RwHexa/ZaehlerModbus/ZaehlerGoogle/ScreenshotZaehler.png

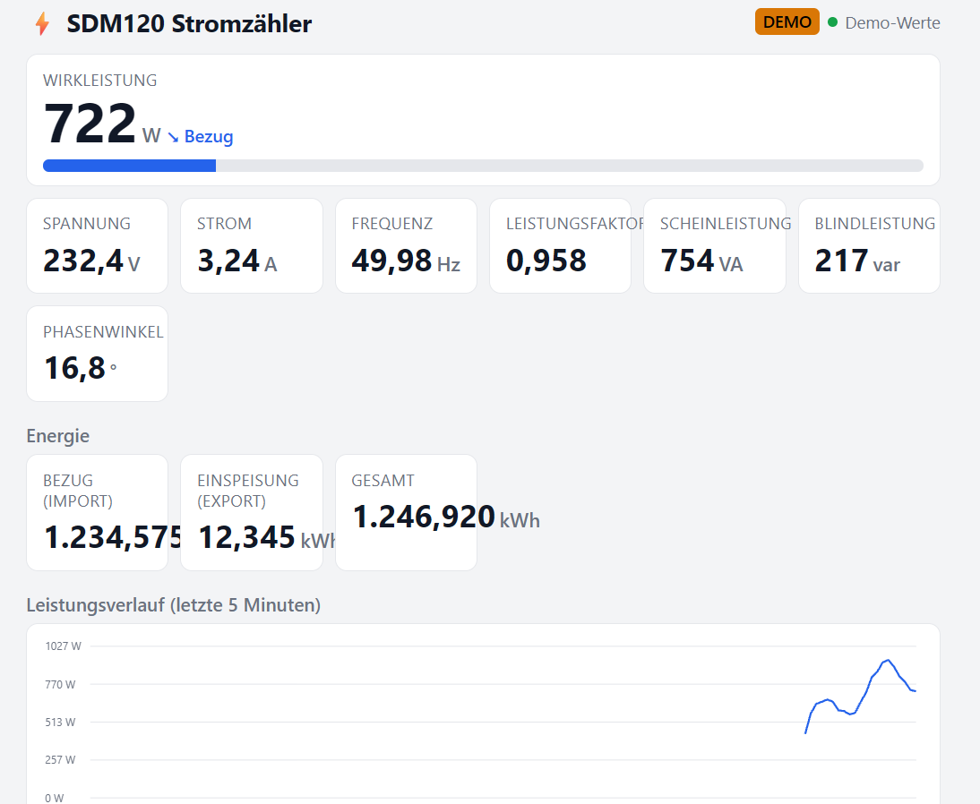
ZaehlerGoogle/ScreenshotZaehler.png
