RwHexa/ZaehlerModbus/ZaehlerGoogle/topologie.png

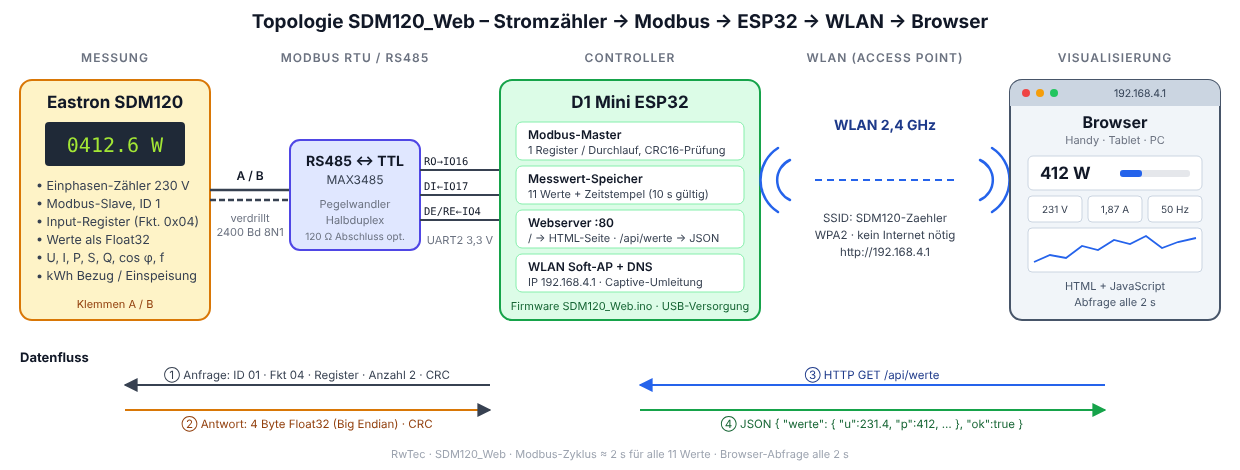
ZaehlerGoogle/topologie.png
