RwHexa/ZaehlerModbus/ZaehlerGoogle/ZaehlerSMD120.png

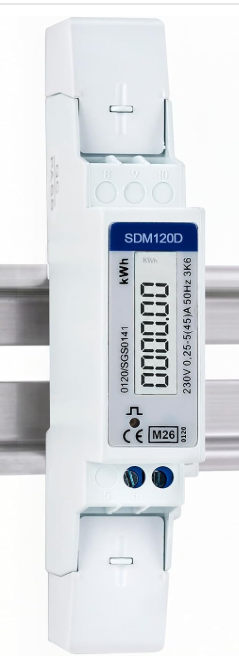
ZaehlerGoogle/ZaehlerSMD120.png
