RwHexa/ZaehlerModbus/(commit log)

2026-10-24 Erste Version: SDM120-Modbus-Gateway fuer D1 Mini ESP32
    Firmware, Konfiguration, Dokumentation und App-Inventor-Projekt.
    MIT-Lizenz, README mit Logo.
2026-10-24 README: Kapitel zu weiterfuehrender Dokumentation
    Links zum Eastron-Handbuch, Datenblatt und Protokoll-PDF, Klemmenbelegung
    laut Handbuch sowie Hinweis zur Zaehlweise der Registeradressen.
    Lizenzkapitel von 13 auf 14 verschoben.
2026-10-24 Empfohlenen RS485-Umsetzer aufnehmen (Waveshare TTL TO RS485 (B))
    Stueckliste, neues Kapitel 2.1 mit Begruendung der galvanischen Trennung,
    Verdrahtung 3.1a (Auto-Modul) und 3.1b (DE/RE-Modul), SGND an Klemme 8 (G),
    aktualisiertes Schaltbild, Checkliste und Fehlersuche.
    config.h: PIN_RS485_DE steht jetzt auf -1 passend zum empfohlenen Modul.
    Die Firmware wertet -1 bereits aus (preTx/postTx und setup), daher keine
    Code-Aenderung noetig.
